Gustavomurta/ESP32_frequencyMeter/ESP32_Frequency_Meter_2CH/Images/ESP32 Freq Meter 2CH LCD.JPG

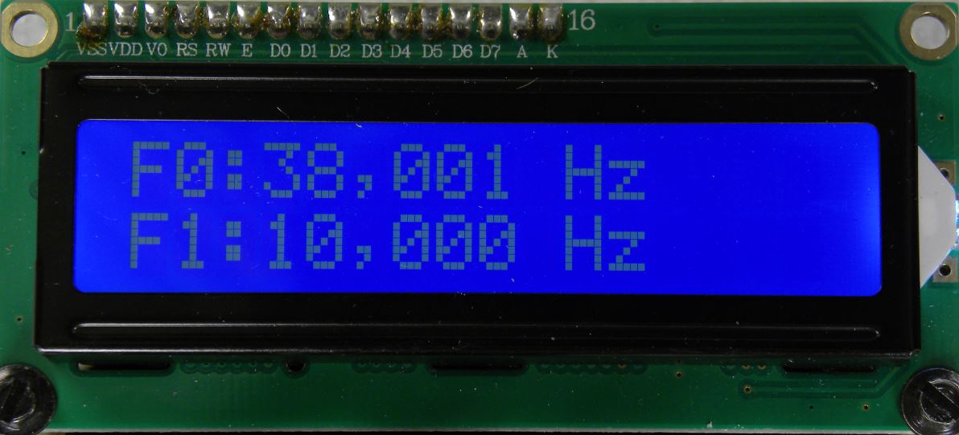
ESP32_Frequency_Meter_2CH/Images/ESP32 Freq Meter 2CH LCD.JPG
