Gustavomurta/ESP32_frequencyMeter/ESP32_Frequency_Meter_2CH/Images/ESP32 Freq Meter 2CH board 20 MHz.JPG

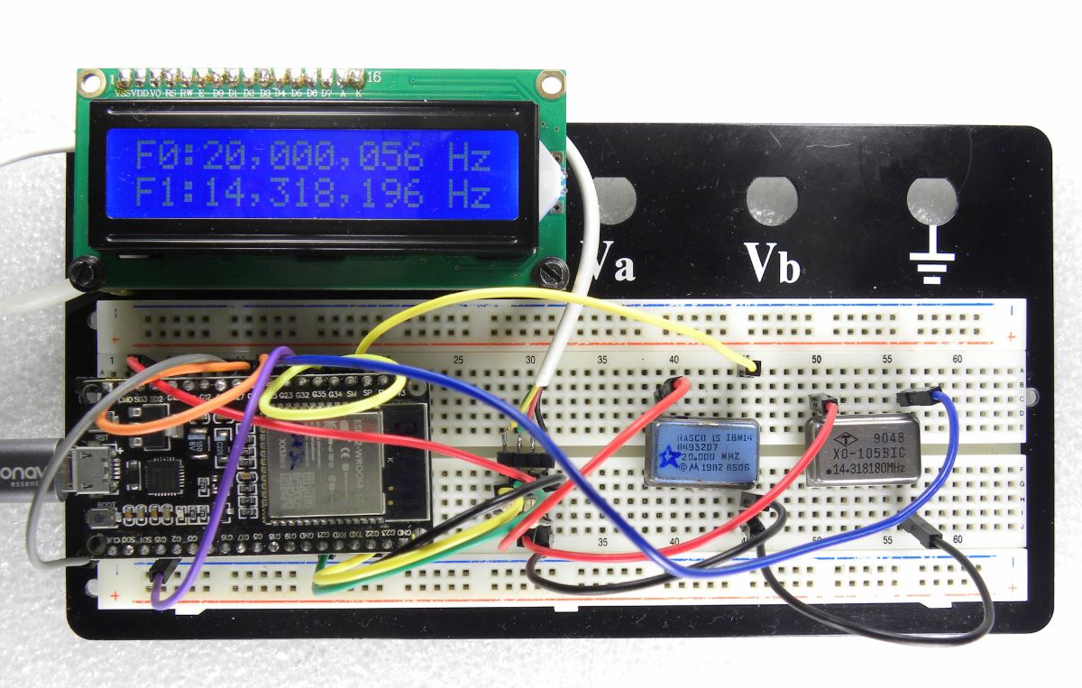
ESP32_Frequency_Meter_2CH/Images/ESP32 Freq Meter 2CH board 20 MHz.JPG
