Gustavomurta/ESP32_frequencyMeter/README.md

# ESP32_frequency Meter
ESP32 - frequencimetro 

Best Frequency Meter ever made with ESP32 - awesome!
https://www.esp32.com/viewtopic.php?f=19&t=17018

ESP32 – Frequencímetro de precisão
https://blog.eletrogate.com/esp32-frequencimetro-de-precisao/
