Gustavomurta/ESP32_frequencyMeter/ESP32freqMeter/README.md

# High Resolution ESP32 Frequency Meter
High Resolution ESP32 Frequency Meter 
Developed by Rui Viana 17/july/2020
Colaborator Gustavo Murta
