Gustavomurta/ESP32_frequencyMeter/ESP32_Frequency_Meter_2CH/Schematics/readme

Schematics edited with KICAD Version 7.0

https://www.kicad.org/

A Cross Platform and Open Source Electronics Design Automation Suite
