Gustavomurta/ESP32_frequencyMeter/ESP32 FreqMeter Arduino/ESP32 Frequencimetro I2C LCD.JPG

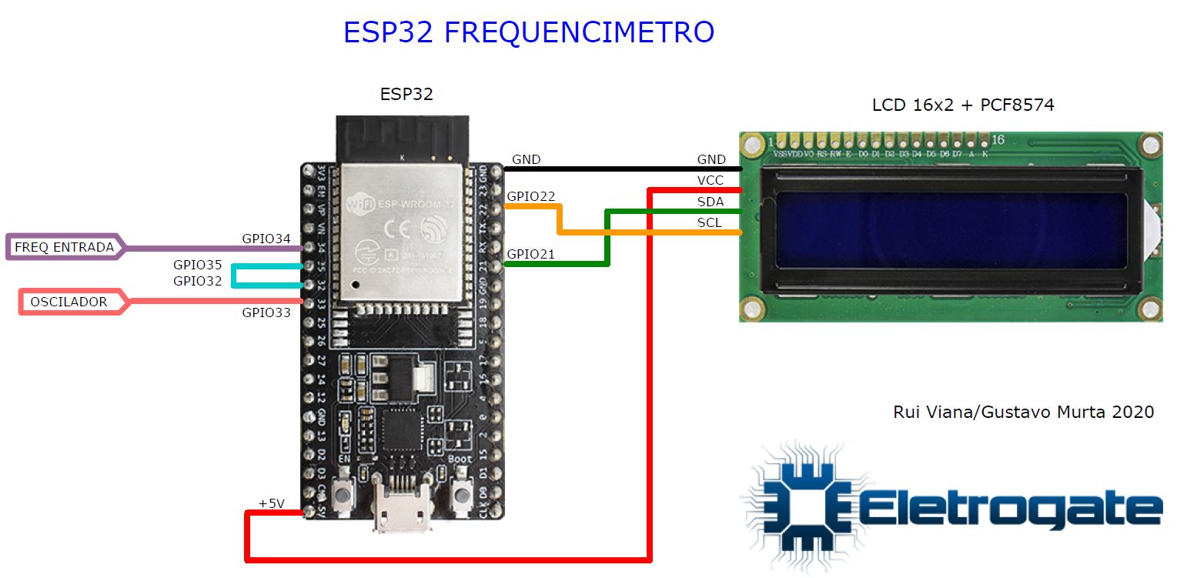
ESP32 FreqMeter Arduino/ESP32 Frequencimetro I2C LCD.JPG
