Gustavomurta/ESP32_frequencyMeter/ESP32 FreqMeter Arduino/ESP32 Frequencimetro LCD.JPG

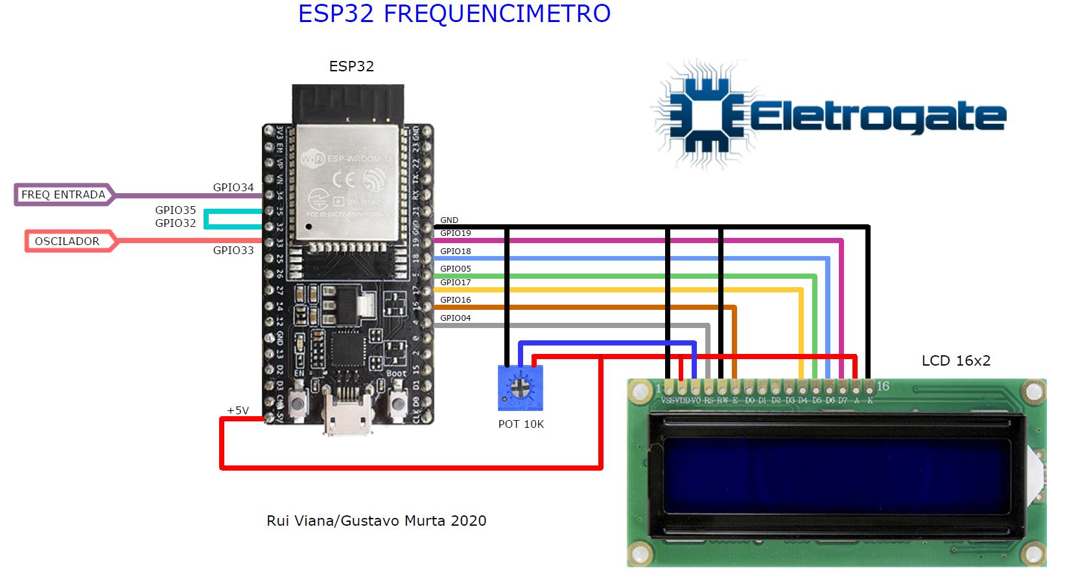
ESP32 FreqMeter Arduino/ESP32 Frequencimetro LCD.JPG
