Gustavomurta/ESP32_frequencyMeter/ESP32_Frequency_Meter_2CH/Images/F0014TEK.JPG

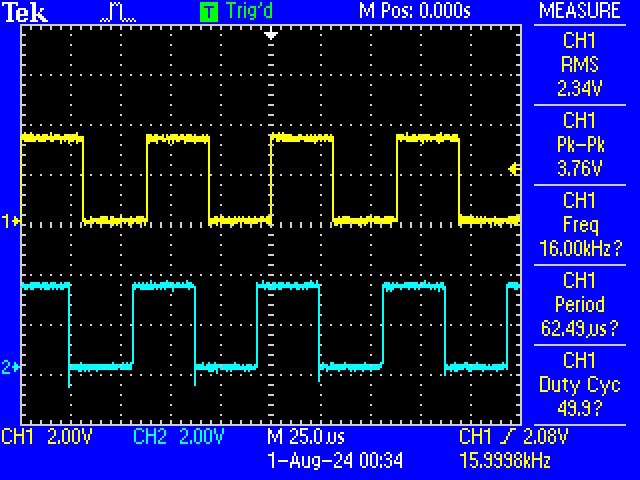
ESP32_Frequency_Meter_2CH/Images/F0014TEK.JPG
