Gustavomurta/ESP32_frequencyMeter/ESP32_Frequency_Meter_2CH/Schematics/ESP32_Frequency_Meter_2CH.JPG

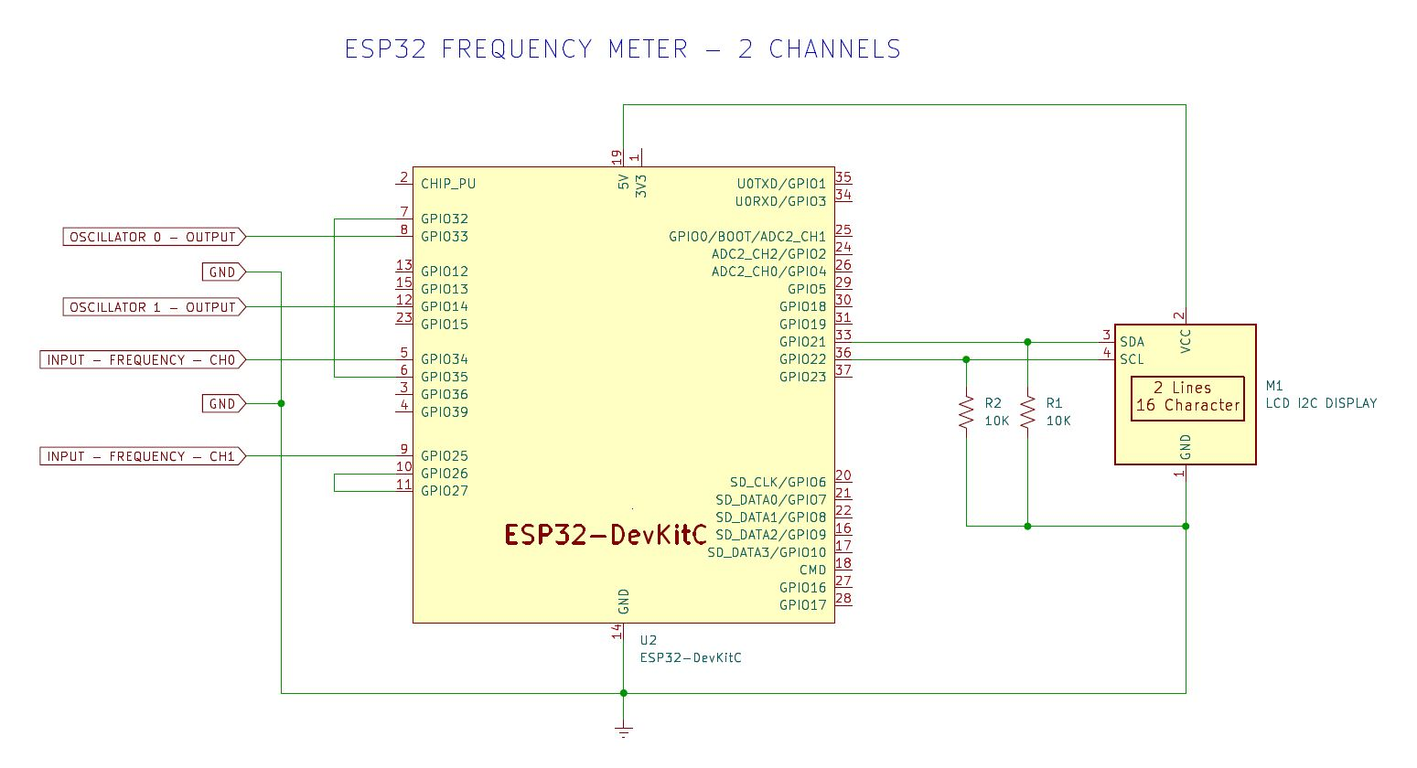
ESP32_Frequency_Meter_2CH/Schematics/ESP32_Frequency_Meter_2CH.JPG
