Gustavomurta/ESP32_frequencyMeter/ESP32_Frequency_Meter_2024/ESP32 Frequency Meter 2024.JPG

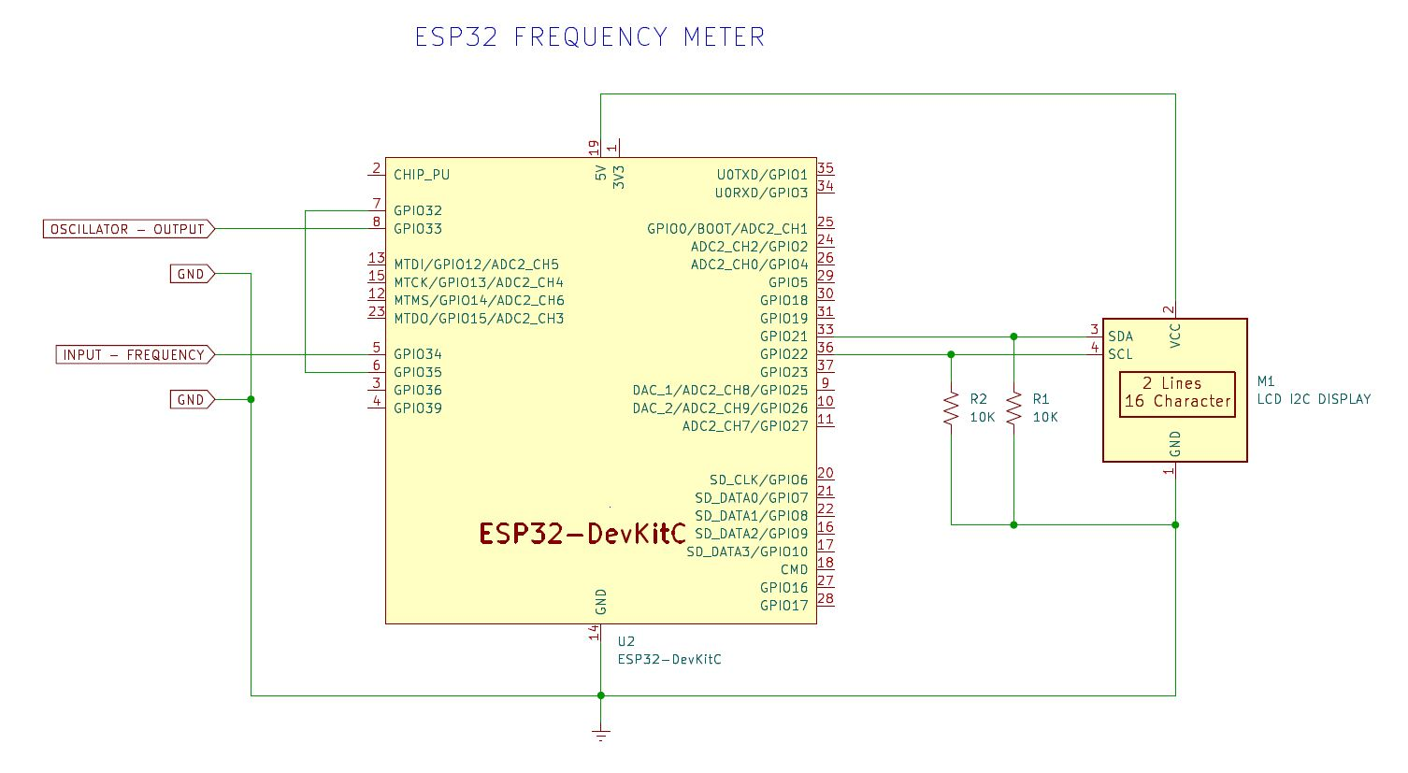
ESP32_Frequency_Meter_2024/ESP32 Frequency Meter 2024.JPG
