Gustavomurta/ESP32_frequencyMeter/ESP32_Frequency_Meter_2024/LCD I2C library.JPG

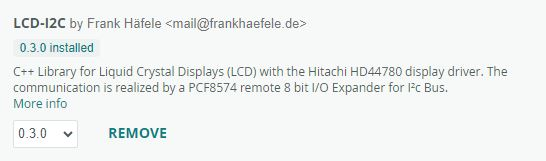
ESP32_Frequency_Meter_2024/LCD I2C library.JPG
