Gustavomurta/ESP32_frequencyMeter/(threads)

Thread 1 (2022-03-16):

reading counter value in interrupt return always zero

mkeyno, 2022-03-16:
Hi,
I've been trying to read the frequency with PCNT lib using your code sample, I've tried to make a class for each channel,  I use the signal generator on ESP32 pin, and enable Maximum counter value event and register an interrupt, however, when an interrupt happens and try to read the counter number, it always returns zero whereas when I trying to read the counter number in the loop, it returns the number
any tip really appreciated

```cpp
#include "driver/pcnt.h"

int inputPin = 14;
int timerMs = 300;
#define UNIT       PCNT_UNIT_0                                 // Unidade de pcnt
#define CHANNEL    PCNT_CHANNEL_0
#define period    50

static pcnt_isr_handle_t isr_handle = nullptr;

volatile int16_t pulseTime_0;

portMUX_TYPE timerMux = portMUX_INITIALIZER_UNLOCKED;

//static
void IRAM_ATTR Intr_handler(void *arg){
portENTER_CRITICAL_ISR(&timerMux);
int16_t p;
int unit = (int)arg;
pcnt_get_counter_value((pcnt_unit_t)unit, &p);
//pcnt_counter_clear((pcnt_unit_t)unit);
pulseTime_0=p;
portEXIT_CRITICAL_ISR(&timerMux);
}

void pcnt_init(void)                                                      // Rotina de inicializacao do pulse count
{
  pcnt_config_t config = { };                                        // Instancia pulse config
  config.pulse_gpio_num = inputPin;                       // Port de entrada dos pulsos
  config.ctrl_gpio_num = -1;                       // Controle da contagem
  config.unit = UNIT;                                     // Unidade de contagem
  config.channel = CHANNEL;                               // Canal de contagem
  config.counter_h_lim = 1000;                             // Limite maximo de contagem
  config.pos_mode = PCNT_COUNT_INC;                                  // Conta na subida do pulso
  config.neg_mode = PCNT_COUNT_DIS;                                  // Conta na descida do pulso
  config.lctrl_mode = PCNT_MODE_KEEP;                             // Nao usado
  config.hctrl_mode = PCNT_MODE_KEEP;                                // Se HIGH conta incrementando

  pcnt_unit_config(&config);                                         // Inicializa PCNT

  pcnt_counter_pause(UNIT);                                    // Inicializa o contador PCNT
  pcnt_counter_clear(UNIT);                                    // Zera o contador PCNT

  pcnt_event_enable(UNIT, PCNT_EVT_H_LIM);

  pcnt_isr_service_install(0);
  pcnt_isr_handler_add(UNIT, Intr_handler, (void *)UNIT);
  //pcnt_isr_register(Intr_handler, NULL, 0, &isr_handle);                    // Rotina de Interrupt de pcnt
  pcnt_intr_enable(UNIT);                                      // Habilita interrup de pcnt

  pcnt_counter_resume(UNIT);                                   // inicia a contagem
}

unsigned long last_measurment;

static uint8_t i=0;

void  measure(void){ if(millis()-last_measurment>period){
int16_t PulseCounter=0;
pcnt_get_counter_value(UNIT,&PulseCounter);
pcnt_counter_clear(UNIT);
pcnt_counter_resume(UNIT);
Serial.println( PulseCounter );

last_measurment = millis();
}}

void setup(){
  Serial.begin(115200);
  Serial.println("frequency measurment ");
  pcnt_init()  ;
}

void loop()
{
///measure();

 if(millis()-last_measurment>period){

Serial.println(pulseTime_0);
last_measurment = millis();
}

}
```

Gustavomurta, 2022-03-16:
Hi Mkeyno,
Look for these links with detailed instructions.

Best Frequency Meter ever made with ESP32 - awesome! https://www.esp32.com/viewtopic.php?f=19&t=17018

ESP32 – Frequencímetro de precisão https://blog.eletrogate.com/esp32-frequencimetro-de-precisao/

Thread 2 (2022-11-21):

Logic analyzer

gusmanb, 2022-11-21:
Hi Gustavo.

Very sorry to have deleted your issue but as I said there are many people that tries to promote their sites spamming project threads so as a rule I remove any issue or comment that links to pages outside Github, feel free to post any link to your repositories.

Once you read this message delete it as it's only to contact you.

Regarding the logic analyzer, if you really want to colaborate there are some things that can be done. First of all, I'm on the works of converting the logic analyzer into an oscilloscope, as the analyzer basic board is nothing else but a breakout of the pico it can be used as base for multiple devices, the idea is to replace the shifter board with a 100msps ADC board and use the pico to acquire the data from it, with this I hope it will become an oscilloscope that will work up to 25Mhz but not . Also, checking your project I think that we could also implement the frequency meter in the device, it should be easy with the current implementation, as the analyzer stores the captured data counting the samples between full cycles should yield the frequency of a signal.

I you're interested you can contact me through the [discussion sections of the repository](https://github.com/gusmanb/logicanalyzer/discussions).

Cheers!
