Gustavomurta/ESP32_frequencyMeter/ESP32_Frequency_Meter_2CH/Schematics/ESP32_Frequency_Meter_2CH.pdf

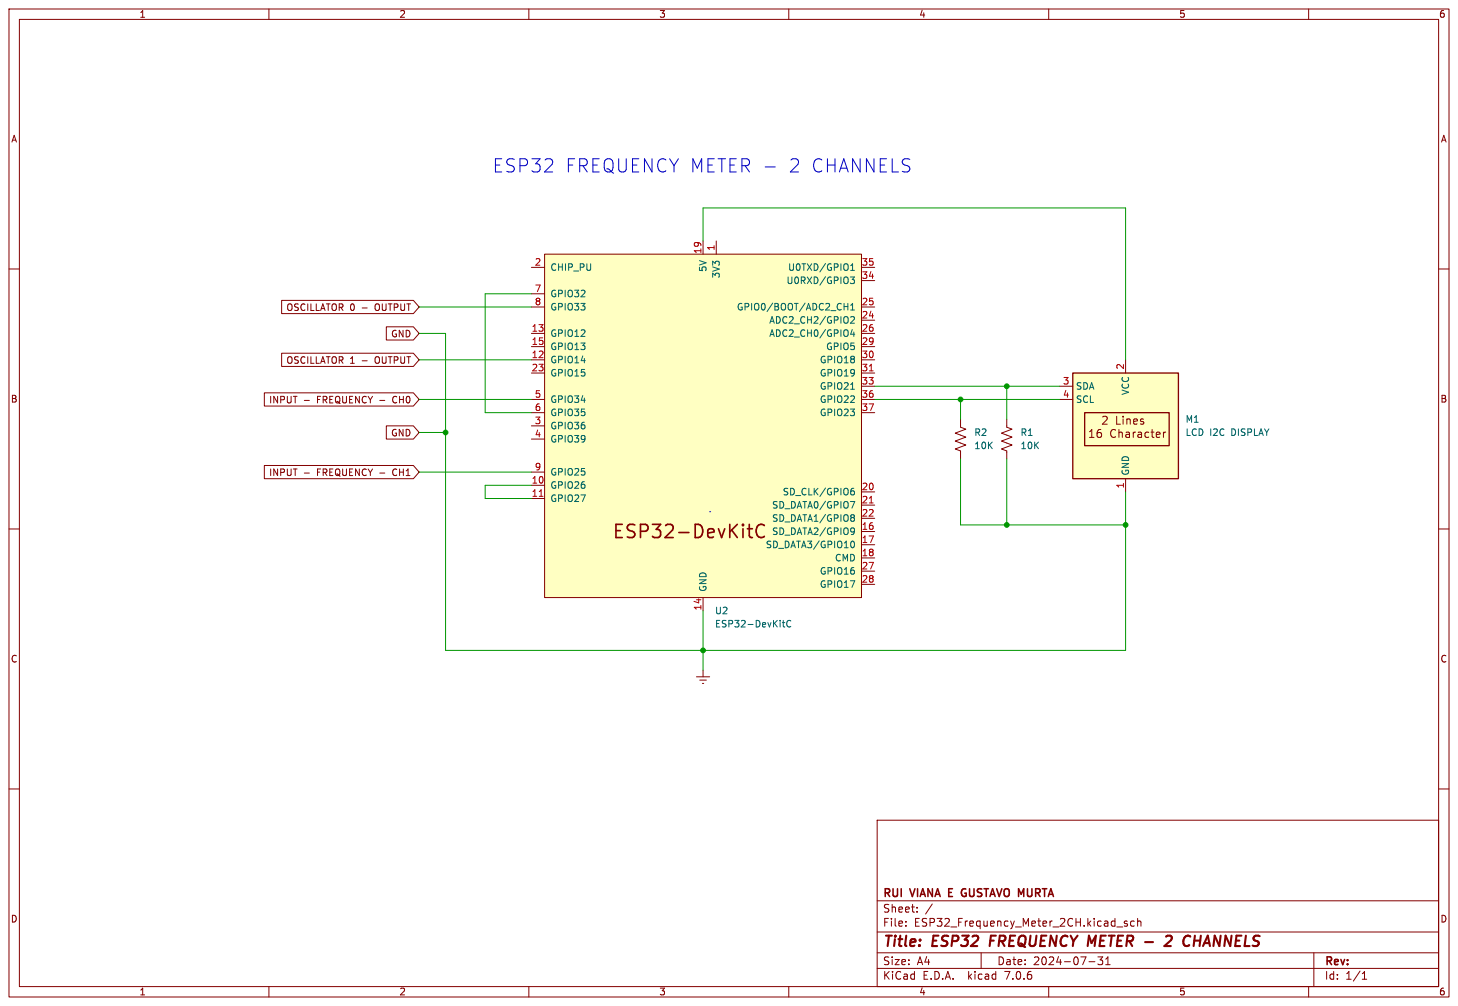
[picture p10: page 1]

10K OSCILLATOR 1 - OUTPUT GND GND

Id: 1/1 Title: ESP32 FREQUENCY METER - 2 CHANNELS
