Gustavomurta/ESP32_frequencyMeter/ESP32_Frequency_Meter_2024/ESP32_Frequency_Meter.pdf

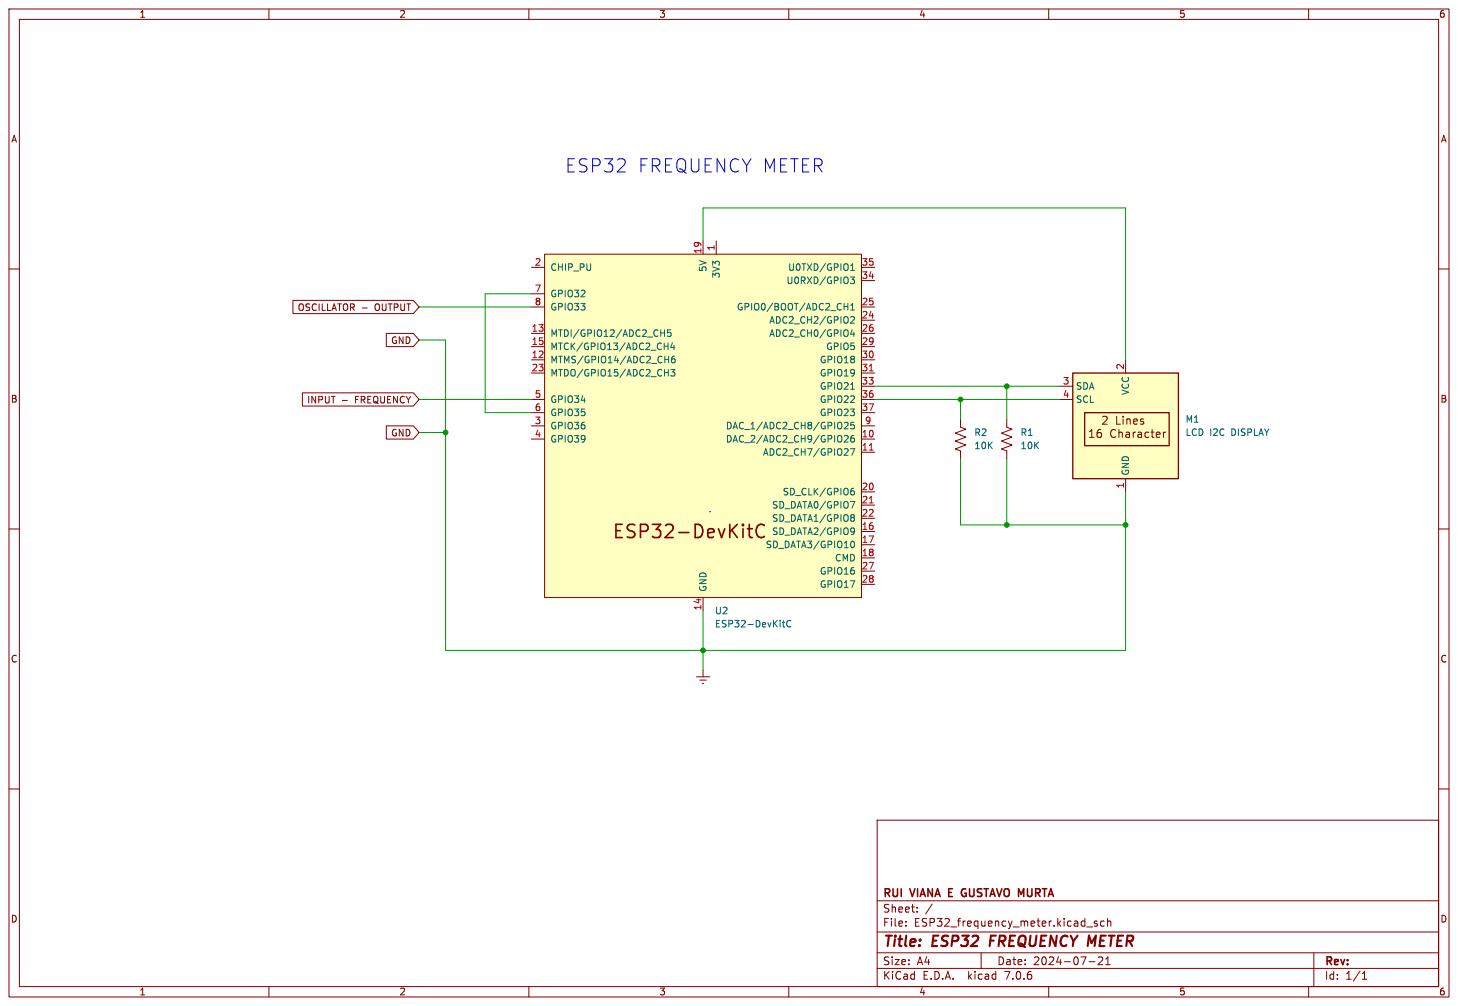
[picture p11: page 1]

1 DAC_2/ADC2_CH9/GPIO26 10 ADC2_CH7/GPIO27 11 MTMS/GPIO14/ADC2_CH6 12 MTDI/GPIO12/ADC2_CH5 13 MTCK/GPIO13/ADC2_CH4 15 SD_DATA2/GPIO9 16 SD_DATA3/GPIO10 17 CMD 18 CHIP_PU 2 SD_CLK/GPIO6 20 SD_DATA0/GPIO7 21 SD_DATA1/GPIO8 22 MTDO/GPIO15/ADC2_CH3 23 ADC2_CH2/GPIO2 24 GPIO0/BOOT/ADC2_CH1 25 ADC2_CH0/GPIO4 26 GPIO16 27 GPIO17 28 GPIO5 29 GPIO36 3 GPIO18 30 GPIO19 31 GPIO21 33 U0RXD/GPIO3 34 U0TXD/GPIO1 35 GPIO22 36 GPIO23 37 GPIO39 4 GPIO34 5 GPIO35 6 GPIO32 7 GPIO33 8 DAC_1/ADC2_CH8/GPIO25 9 U2ESP32-DevKitC GND

2 SDA 3 SCL 4 M1 R2 LCD I2C DISPLAY

Id: 1/1 Title: ESP32 FREQUENCY METER
