Gustavomurta/ESP32_frequencyMeter/ESP32_Frequency_Meter_2CH/Schematics/ESP32_Frequency_Meter_2CH.kicad_sch

## KiCad design ESP32_Frequency_Meter_2CH/Schematics/ESP32_Frequency_Meter_2CH.kicad_sch (2024-08-01)

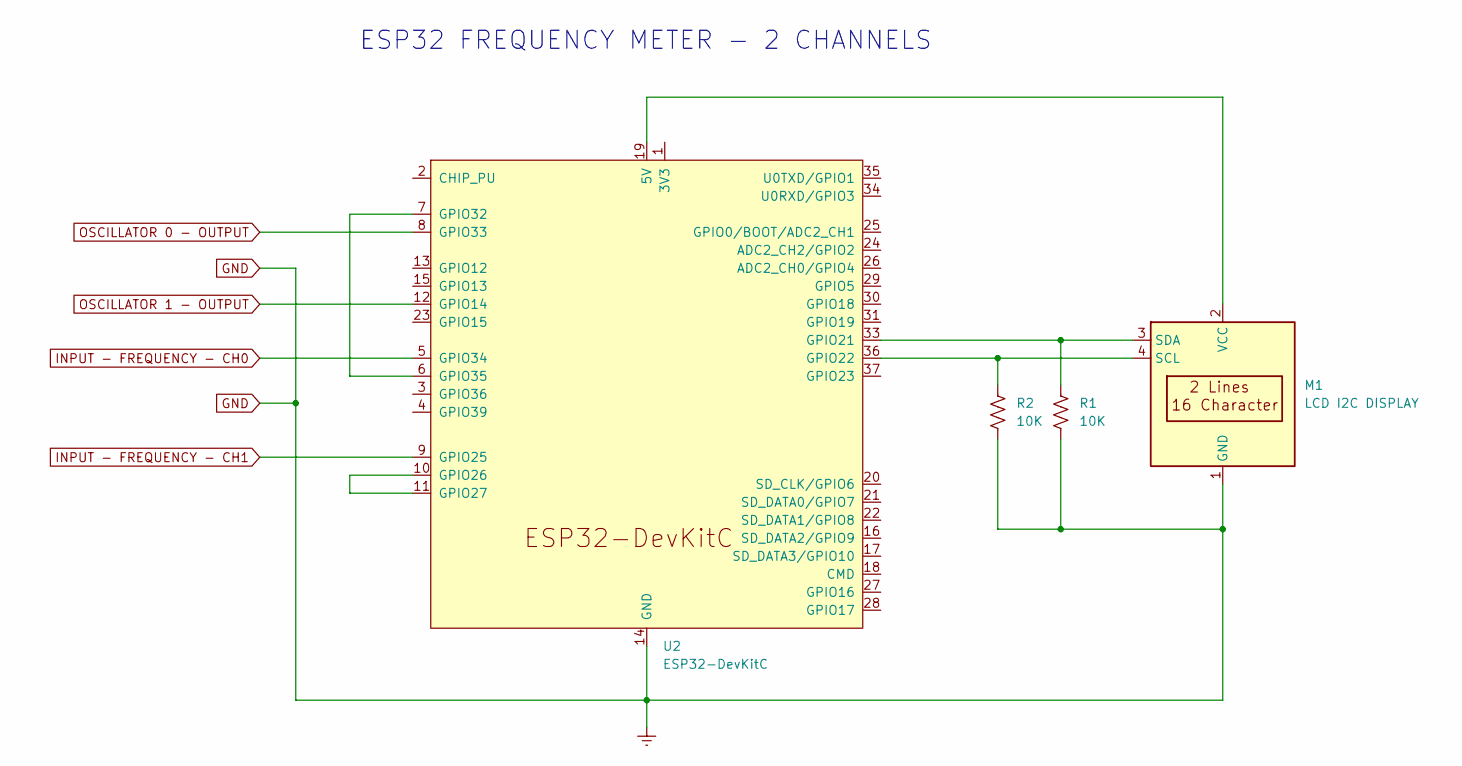
[picture p12: schematic ESP32_Frequency_Meter_2CH.kicad_sch]

Parts:
M1: LCD I2C DISPLAY; EA_T123X-I2C
R1, R2: 10K
U2: ESP32-DevKitC

Connections:
Earth: M1.1 (GND), R1.2, R2.2, U2.14 (GND), U2.32 (GND), U2.38 (GND)
INPUT - FREQUENCY - CH0: U2.5 (GPIO34)
INPUT - FREQUENCY - CH1: U2.9 (GPIO25)
unnamed: M1.2 (VCC), U2.19 (5V)
unnamed: M1.3 (SDA), R1.1, U2.33 (GPIO21)
unnamed: M1.4 (SCL), R2.1, U2.36 (GPIO22)
unnamed: U2.6 (GPIO35), U2.7 (GPIO32)
unnamed: U2.10 (GPIO26), U2.11 (GPIO27)
OSCILLATOR 0 - OUTPUT: U2.8 (GPIO33)
OSCILLATOR 1 - OUTPUT: U2.12 (GPIO14)

Notes on the sheet:
ESP32 FREQUENCY METER - 2 CHANNELS
