Gustavomurta/ESP32_frequencyMeter/ESP32freqMeter/main/ESP32freqMeter.c

/* ESP32 HIGH ACCURACY FREQUENCY METER version 0.33.0

   DEVELOPER : Rui Viana
   CONTRIBUITORS: Gustavo Murta / Celso Ito
   DATE: 17/jul/2020

  ESP32 Dev Kit - ESP-IDF V4.0.1 or ARDUINO IDE 1.8.12
  This project can be compiled with the arduino IDE or the IDF! (change the extension to .INO to compile Arduino)
  https://github.com/Gustavomurta/ESP32_frequenceMeter/blob/master/ESP32freqMeter/main/ESP32freqMeter.c

  Optional = Parallel LCD or I2C LCD (see pins connections in the program)

  The project:
  A high accuracy frequency meter using ESP32, without scales and showing up to 8 digits,
  measuring up to 40 MHz. Very stable. Optionally, you can test the frequency meter with internal oscillator.
  Caution = input signal to Freq Meter - only 3.3 Volts! If you want 5 Volts, use level converter.

  Definitions:

  GPIO_34 =  Freq Meter Input
  GPIO_25 =  Oscillator output - to test Frequency Meter
  To test freq Meter with internal oscillator, make connection between GIPO_34 and GPIO_25 (optional).
  Change frequency, inputting value at console (1 Hz to 40 Mhz)

  GPIO_35 = Pulse Counter control input - HIGH =count up, LOW=count down
  GPIO_32 = High Resolution Timer output (to control Pulse Counter)
  Make connection between GPIO_35 to GPIO_32 to use Frequency Meter (must have).

  If you need, can change GPIOs pins

  The frequency meter is divided into 5 parts:
     1. Pulse counter;
     2. Counting time control;
     3. Printing the result;
     4. Space for other functions.
     5. Signal generator programmed for 2 Hz (or 50,000)

  1. The pulse counter uses the ESP32 pcnt.
      Pcnt has the following parameters:
       a. input port;
       b. input channel;
       c. control port;
       d. count on Pulse raising;
       e. count on Pulse falling;
       f. counting only with Control - high level;
       g. maximum count limit.

  2. Counting time control uses the high resolution esp-timer:
      The esp-timer has the following parameter:
       a. time control;

   5. Frequency generator for tests, uses ledc peripheral:
      The ledc has the following parameters:
       a. output port;
       B. lcd channel;
       ç. frequency;
       d. resolution of ledc;
       e. duty cycle at 50%;

  Operation:

  The high level of control port enable the counter to count the pulses that arrive at the input port.
  Pulses are counted both as the pulse rising and falling, to improve the counting average.
  The sampling time is defined by the high resolution esp-timer, and it is defined in 1 second, in the sample-time variable.
  If the count is greater than 20000 pulses during the counting time, overflow occurs and for with each overflow that occurs
  the multPulses variable is incremented. Then pulse counter is cleared and proceed to counting.
  Unfortunately the Pulse Counter has only 16 bits that may be used.

  When the sampling time ends, a routine is called and the value in the pulse counter is read and saved.
  A flag is set on to indicating that the pulse reading has ended.

  In the loop, when verifying if the flag is on indicates that the pulse reading has finished, the value is calculated by multiplying
  the number of overflow by 20000 and adding to the number of remaining pulses and dividing by 2, because it counted 2 times.

  As the pulses are counted on the way up and down, the count is double the frequency.
  In the frequency value, commas are inserted and printed on the serial monitor.
  The registers are reset and the input control port is set to a high level again and the pulse count starts.

  It also has a signal oscillator that generates pulses, and can be used for testing.
  This oscillator can be configured to generate frequencies up to 40 MHz.
  We use the LEDC peripheral of ESP32 to generate frequency that can be used as a test.
  The base frequency value is 1000 Hz, but it can be typed to another value on the serial monitor.
  The deafault duty cycle was set to 50%, and the resolution is properly calculated.
  The output port of this generator is currently defined as GPIO 25.

  Internally using GPIO matrix, the input pulse was directed to the ESP32 native LED,
  so the LED will flash at the input frequency.

  The compiler uses the compilation directives to select:
  Using LCD     =   LCD_ON or LCD_OFF
  Using LCD I2C =   LCD_I2C_ON or LCD_I2C_OFF

  Calculation of adjustments for each frequency range:
  Resolution = log2(Clock(80 MHz)/osc_freq)    ex: 50,000 Hz = 80,0000/50,000 = 1,600    log2(1600) = 10.64
  Duty cycle 50%  = (2**Resolution)/2          ex: 2**10 = 1024      1024/2 = 512

  References:
  https://github.com/espressif/esp-idf/tree/master/examples/peripherals/pcnt
  https://docs.espressif.com/projects/esp-idf/en/latest/esp32/api-reference/peripherals/pcnt.html
  https://docs.espressif.com/projects/esp-idf/en/latest/esp32/api-reference/system/esp_timer.html
  https://docs.espressif.com/projects/esp-idf/en/latest/esp32/api-reference/peripherals/ledc.html
  ESP332 Oscillator https://github.com/Gustavomurta/ESP32_frequenceMeter/blob/master/ESP32OscilatorV03.ino
  Answer of Deouss » Thu May 17, 2018 3:07 pm no tópico https://esp32.com/viewtopic.php?t=5734
  Formatting numbers  https://arduino.stackexchange.com/questions/28603/the-most-effective-way-to-format-numbers-on-arduino

*/

#define LCD_OFF                                                           // To use LCD, set LCD_ON 
#define LCD_I2C_OFF                                                       // To use I2C LCD, set LCD_I2C_ON

#include <stdio.h>                                                        // Libraries 
#include "freertos/FreeRTOS.h"
#include "freertos/portmacro.h"
#include "freertos/task.h"
#include "freertos/queue.h"
#include "driver/periph_ctrl.h"
#include "driver/ledc.h"
#include "driver/gpio.h"
#include "driver/pcnt.h"
#include "driver/ledc.h"
#include "esp_attr.h"
#include "esp_log.h"
#include "esp_timer.h"
#include "sdkconfig.h"
#include "math.h"

#ifdef LCD_I2C_ON                                                         // If using I2C LCD 
#include <LiquidCrystal_I2C.h>                                            // LCD I2C Library 
LiquidCrystal_I2C lcd(0x3F, 16, 2);                                       // Define I2C address, columns and rows. Use I2C scanner to identify address
#endif

#ifdef LCD_ON                                                             // If using LCD
#include <LiquidCrystal.h>                                                // LCD Library
LiquidCrystal lcd(5, 18, 19, 21, 22, 23);                                 // Define LCD pins at parallel interface
#endif

#define PCNT_COUNT_UNIT       PCNT_UNIT_0                                 // Set Pulse Counter Unit - 0 
#define PCNT_COUNT_CHANNEL    PCNT_CHANNEL_0                              // Set Pulse Counter channel - 0 
#define PCNT_INPUT_SIG_IO     GPIO_NUM_34                                 // Set Pulse Counter input - Freq Meter Input GPIO 34
#define PCNT_INPUT_CTRL_IO    GPIO_NUM_35                                 // Set Pulse Counter Control GPIO pin - HIGH = count up, LOW = count down 
#define OUTPUT_CONTROL_GPIO   GPIO_NUM_32                                 // Saida do timer GPIO 32 Controla a contagem
#define IN_BOARD_LED          (gpio_num_t)2                               // ESP32 LED - GPIO 2
#define LEDC_HS_CH0_CHANNEL   LEDC_CHANNEL_0                              // Set LEDC high speed Channel - 0
#define LEDC_HS_MODE          LEDC_HIGH_SPEED_MODE                        // Set High speed mode
#define LEDC_HS_TIMER         LEDC_TIMER_0                                // Set LEDC HS Timer - 0
#define LEDC_HS_CH0_GPIO      GPIO_NUM_25                                 // Set LEDC HS_CH0 output pin - Oscillator output GPIO 25 

uint32_t         overflow  =  20000;                                      // Max Pulse Counter value
#define PCNT_H_LIM_VAL        overflow                                    // High Limit value of Pulse Counter 

esp_timer_create_args_t create_args;                                      // Create an esp_timer instance
esp_timer_handle_t timer_handle;                                          // Create an single timer

bool            flag          = true;                                     // Flag to enable print frequency reading
int16_t         pulses        = 0;                                        // Pulse Counter value
uint32_t        multPulses    = 0;                                        // Overflows count value
uint32_t        sample_time   = 1000000;                                  // Sampling time of one second
uint32_t        osc_freq      = 1000;                                     // Oscillator frequency - initial 1000 Hz (1 Hz to 40 Mhz)
uint32_t        mDuty         = 0;                                        // Duty value
uint32_t        resolution    = 0;                                        // Resolution value

portMUX_TYPE timerMux = portMUX_INITIALIZER_UNLOCKED;                     // portMUX_TYPE to do synchronism

//----------------------------------------------------------------------------------------
char *ultos_recursive(unsigned long val, char *s, unsigned radix, int pos) // Format an unsigned long (32 bits) into a string
{
  int c;
  if (val >= radix)
    s = ultos_recursive(val / radix, s, radix, pos + 1);
  c = val % radix;
  c += (c < 10 ? '0' : 'a' - 10);
  *s++ = c;
  if (pos % 3 == 0) *s++ = ',';
  return s;
}

//----------------------------------------------------------------------------------------
char *ltos(long val, char *s, int radix)                                   // Format an long (32 bits) into a string
{
  if (radix < 2 || radix > 36) {
    s[0] = 0;
  } else {
    char *p = s;
    if (radix == 10 && val < 0) {
      val = -val;
      *p++ = '-';
    }
    p = ultos_recursive(val, p, radix, 0) - 1;
    *p = 0;
  }
  return s;
}

//----------------------------------------------------------------------------
void ledcInit ()                                                          // Optional Pulse Oscillator to test Freq Meter
{
  resolution = (log(80000000 / osc_freq) / log(2)) / 2;                   // Calc of resolution divided by 2 for accuracy
  if (resolution < 1) resolution = 1;                                     // min resolution
  // Serial.println(resolution);
  mDuty = (pow(2, resolution)) / 2;                                       // Calc of Duty Cycle 50% - oscillator
  //  Serial.println(mDuty);

  ledc_timer_config_t ledc_timer = {};                                    // LEDC timer config instance

  ledc_timer.duty_resolution = ledc_timer_bit_t (resolution);             // Set resolution
  ledc_timer.freq_hz    = osc_freq;                                       // Set Oscillator frequency
  ledc_timer.speed_mode = LEDC_HIGH_SPEED_MODE;                           // Set high speed mode
  ledc_timer.timer_num = LEDC_TIMER_0;                                    // Set LEDC timer index - 0
  ledc_timer_config(&ledc_timer);                                         // Set LEDC Timer config

  ledc_channel_config_t ledc_channel = {};                                // LEDC Channel config instance

  ledc_channel.channel    = LEDC_HS_CH0_CHANNEL;                          // Set HS Channel - 0
  ledc_channel.duty       = mDuty;                                        // Set Duty Cycle 50%
  ledc_channel.gpio_num   = LEDC_HS_CH0_GPIO;                             // LEDC output gpio
  ledc_channel.intr_type  = LEDC_INTR_DISABLE;                            // LEDC Fade interrupt disable
  ledc_channel.speed_mode = LEDC_HIGH_SPEED_MODE;                         // Set LEDC high speed mode
  ledc_channel.timer_sel  = LEDC_TIMER_0;                                 // Set timer source of channel - 0

  ledc_channel_config(&ledc_channel);                                     // Config LEDC channel
}

//----------------------------------------------------------------------------------
void read_PCNT(void *p)                                                   // Read Pulse Counter
{
  gpio_set_level(OUTPUT_CONTROL_GPIO, 0);                                 // Stop counter - output control LOW
  pcnt_get_counter_value(PCNT_COUNT_UNIT, &pulses);                       // Read Pulse Counter value
  flag = true;                                                            // Change flag to enable print
}

//----------------------------------------------------------------------------------
static void IRAM_ATTR pcnt_intr_handler(void *arg)                        // Counting overflow pulses
{
  portENTER_CRITICAL_ISR(&timerMux);                                      // disabling the interrupts
  multPulses++;                                                           // increment Overflow counter
  PCNT.int_clr.val = BIT(PCNT_COUNT_UNIT);                                // Clear Pulse Counter interrupt bit
  portEXIT_CRITICAL_ISR(&timerMux);                                       // enabling the interrupts
}

//----------------------------------------------------------------------------------
void pcnt_init(void)                                                      // Initialize and run PCNT unit
{
  pcnt_config_t pcnt_config = { };                                        // PCNT unit instance

  pcnt_config.pulse_gpio_num = PCNT_INPUT_SIG_IO;                         // Pulse input GPIO 34 - Freq Meter Input
  pcnt_config.ctrl_gpio_num = PCNT_INPUT_CTRL_IO;                         // Control signal input GPIO 35
  pcnt_config.unit = PCNT_COUNT_UNIT;                                     // PCNT unit number - 0
  pcnt_config.channel = PCNT_COUNT_CHANNEL;                               // PCNT channel number - 0
  pcnt_config.counter_h_lim = PCNT_H_LIM_VAL;                             // Maximum counter value - 20000
  pcnt_config.pos_mode = PCNT_COUNT_INC;                                  // PCNT positive edge count mode - inc
  pcnt_config.neg_mode = PCNT_COUNT_INC;                                  // PCNT negative edge count mode - inc
  pcnt_config.lctrl_mode = PCNT_MODE_DISABLE;                             // PCNT low control mode - disable
  pcnt_config.hctrl_mode = PCNT_MODE_KEEP;                                // PCNT high control mode - won't change counter mode
  pcnt_unit_config(&pcnt_config);                                         // Initialize PCNT unit

  pcnt_counter_pause(PCNT_COUNT_UNIT);                                    // Pause PCNT unit
  pcnt_counter_clear(PCNT_COUNT_UNIT);                                    // Clear PCNT unit

  pcnt_event_enable(PCNT_COUNT_UNIT, PCNT_EVT_H_LIM);                     // Enable event to watch - max count
  pcnt_isr_register(pcnt_intr_handler, NULL, 0, NULL);                    // Setup Register ISR handler
  pcnt_intr_enable(PCNT_COUNT_UNIT);                                      // Enable interrupts for PCNT unit

  pcnt_counter_resume(PCNT_COUNT_UNIT);                                   // Resume PCNT unit - starts count
}

//----------------------------------------------------------------------------------
void myInit()
{
#ifdef LCD_ON                                                             // If using LCD
  lcd.begin(16, 2);                                                       // LCD init
  lcd.print("Frequency Meter");                                           // Print
#endif

  ledcInit();                                                             // Init LEDC peripheral
  pcnt_init();                                                            // Init Pulse Counter peripheral
  gpio_pad_select_gpio(OUTPUT_CONTROL_GPIO);                              // Set GPIO pad
  gpio_set_direction(OUTPUT_CONTROL_GPIO, GPIO_MODE_OUTPUT);              // Set GPIO direction

  create_args.callback = read_PCNT;                                       // Set esp-timer argument
  esp_timer_create(&create_args, &timer_handle);                          // Create esp-timer instance

  gpio_set_direction(IN_BOARD_LED, GPIO_MODE_OUTPUT);                     // Set LED inboard as output

  gpio_matrix_in(PCNT_INPUT_SIG_IO, SIG_IN_FUNC226_IDX, false);           // Set GPIO matrin IN - Freq Meter input
  gpio_matrix_out(IN_BOARD_LED, SIG_IN_FUNC226_IDX, false, false);        // Set GPIO matrix OUT - to inboard LED
}

//---------------------------------------------------------------------------------
void app_main(void)                                                       // main application
{
#ifndef ARDUINO                                                           // IDF
  myInit();                                                               // IDF
  while (1)                                                               // IDF
  {
#endif
    if (flag == true)                                                     // If count has ended
    {
      flag = false;                                                       // change flag to disable print
      float frequency = 0;                                                // Clear variable frequency
      frequency = (pulses + (multPulses * overflow)) / 2  ;               // Calculation of frequency
      char buf[32];                                                       // Create buffer
      printf("Frequency: %s", (ltos(frequency, buf, 10)));                // Print frequency
      printf(" Hz \n");                                                   // Print unit

#ifdef LCD_I2C_ON                                                         // LCD
      lcd.setCursor(0, 0);                                                // Set cursor position - column and row
      lcd.print("Frequency Meter");                                       // Print
      lcd.setCursor(1, 1);                                                // Set cursor position - column and row
      lcd.print((ltos(frequency, buf, 10)));                              // Print frequency
      lcd.print(" Hz              ");                                     // Print unit
#endif
      multPulses = 0;                                                     // Clear overflow counter
      // Put your function here, if you want
      vTaskDelay(1);                                                      // delay 1 milisecond
      // Put your function here, if you want
      pcnt_counter_clear(PCNT_COUNT_UNIT);                                // Clear Pulse Counter
      esp_timer_start_once(timer_handle, sample_time);                    // Initialize High resolution timer (1 sec)
      gpio_set_level(OUTPUT_CONTROL_GPIO, 1);                             // Porta de controle habilita contagem dos pulsos
    }
#ifndef ARDUINO                                                           // IDF
  }                                                                       // IDF
#endif
}

//---------------------------------------------------------------------------------
#ifdef ARDUINO                                                            // if Arduino IDE
void setup()
{
  Serial.begin(115200);                                                   // Init Serial Console Arduino 115200 Bps
  myInit();                                                               // Initial setup
#ifdef LCD_I2C_ON                                                         // LCD
  lcd.init();                                                             // Init I2C LCD
  lcd.backlight();                                                        // Set I2C LCD Backlight ON
#endif
}

//---------------------------------------------------------------------------------
void loop()
{
  app_main();                                                             // main application
  String inputString = "";                                                // clear temporary string
  osc_freq = 0;                                                           // clear oscillator value
  while (Serial.available())
  {
    char inChar = (char)Serial.read();                                    // Reads a byte on the console
    inputString += inChar;                                                // Add char to string
    if (inChar == '\n')                                                   // If new line (enter)
    {
      osc_freq = inputString.toInt();                                     // Converts String into integer value
      inputString = "";                                                   // Clear string
    }
  }
  if (osc_freq != 0)                                                      // If some value inputted to oscillator frequency
  {
    ledcInit();                                                           // reconfigure ledc function
  }
}
#endif
