Gustavomurta/ESP32_frequencyMeter/(commit log)

2022-11-21 Add files via upload
    ESP32 Precision Frequency Meter and Clock Generator - Arduino IDE
    1 Hz to 40 MHz
2022-11-21 Rename ESP32_PrecisionFreqMeter.ino to ESP32 FreqMeter Arduino/ESP32_PrecisionFreqMeter.ino
2022-11-21 Rename ESP32_FreqMeterV20a.ino to Old tests/ ESP32_FreqMeterV20a.ino
